cristianoag/MSXUSB/hardware/discontinued/kicad-discrete/MSX USB Drive.png

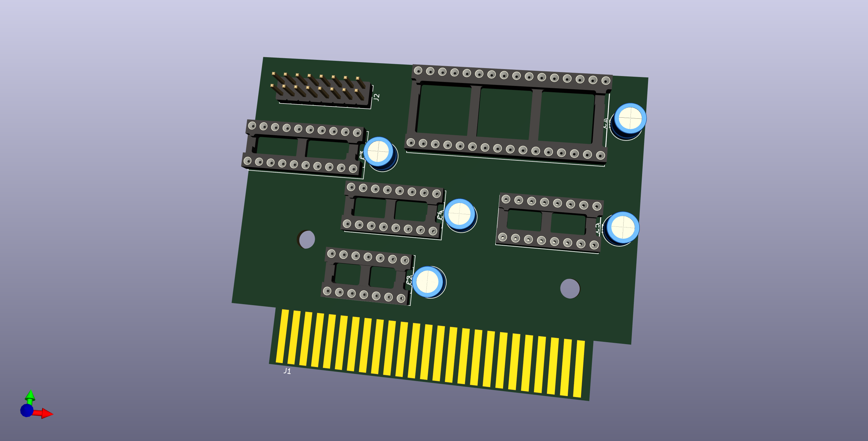
hardware/discontinued/kicad-discrete/MSX USB Drive.png
