cristianoag/MSXUSB/images/2024-11-18_18-22.png

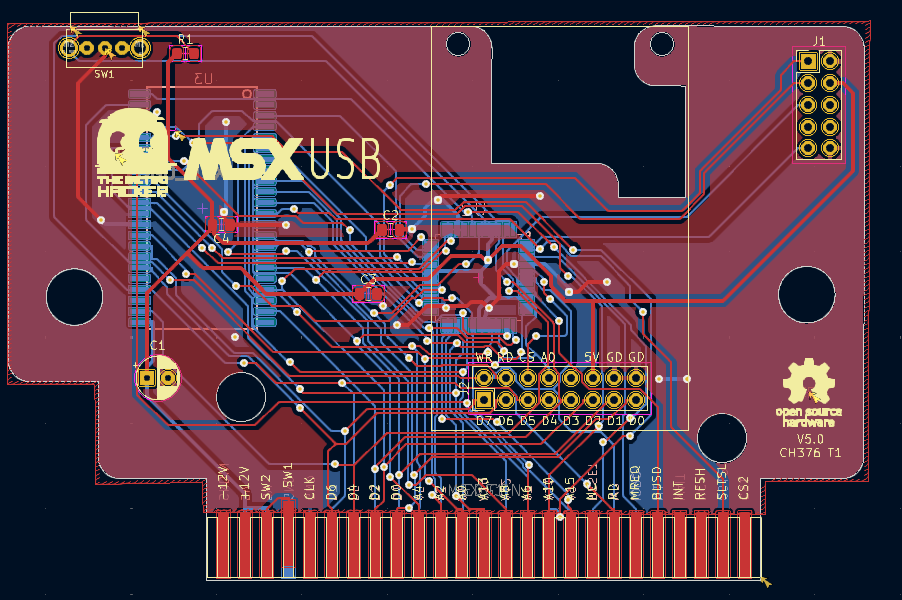
images/2024-11-18_18-22.png
