cristianoag/MSXUSB/(list of files, cad)

Other CAD files:
hardware/v3/quartus/simulation/modelsim/rtl_work/ch376/verilog.psm
hardware/v3/quartus/simulation/modelsim/rtl_work/msxusb/verilog.psm
hardware/v3/quartus/simulation/modelsim/rtl_work/scc_rom_mapper/verilog.psm
hardware/v3/quartus/simulation/modelsim/rtl_work/t_ch376/verilog.psm
hardware/v3/quartus/simulation/modelsim/rtl_work/t_scc_rom_mapper/verilog.psm
hardware/v4/quartus-rev4/simulation/modelsim/rtl_work/ch376/verilog.psm
hardware/v4/quartus-rev4/simulation/modelsim/rtl_work/msxusb/verilog.psm
hardware/v4/quartus-rev4/simulation/modelsim/rtl_work/scc_rom_mapper/verilog.psm
hardware/v4/quartus-rev4/simulation/modelsim/rtl_work/t_ch376/verilog.psm
hardware/v4/quartus-rev4/simulation/modelsim/rtl_work/t_scc_rom_mapper/verilog.psm
hardware/v5/cpld/7064STC44/simulation/modelsim/rtl_work/ch376/verilog.psm
hardware/v5/cpld/7064STC44/simulation/modelsim/rtl_work/msxusb/verilog.psm
hardware/v5/cpld/7064STC44/simulation/modelsim/rtl_work/scc_rom_mapper/verilog.psm
hardware/v5/cpld/7064STC44/simulation/modelsim/rtl_work/t_ch376/verilog.psm
hardware/v5/cpld/7064STC44/simulation/modelsim/rtl_work/t_scc_rom_mapper/verilog.psm
