cristianoag/MSXUSB/hardware/v5/kicad/CH276S-Type1/MSX USB Drive.kicad_pcb

## KiCad design hardware/v5/kicad/CH276S-Type1/MSX USB Drive.kicad_pcb (2025-03-21)

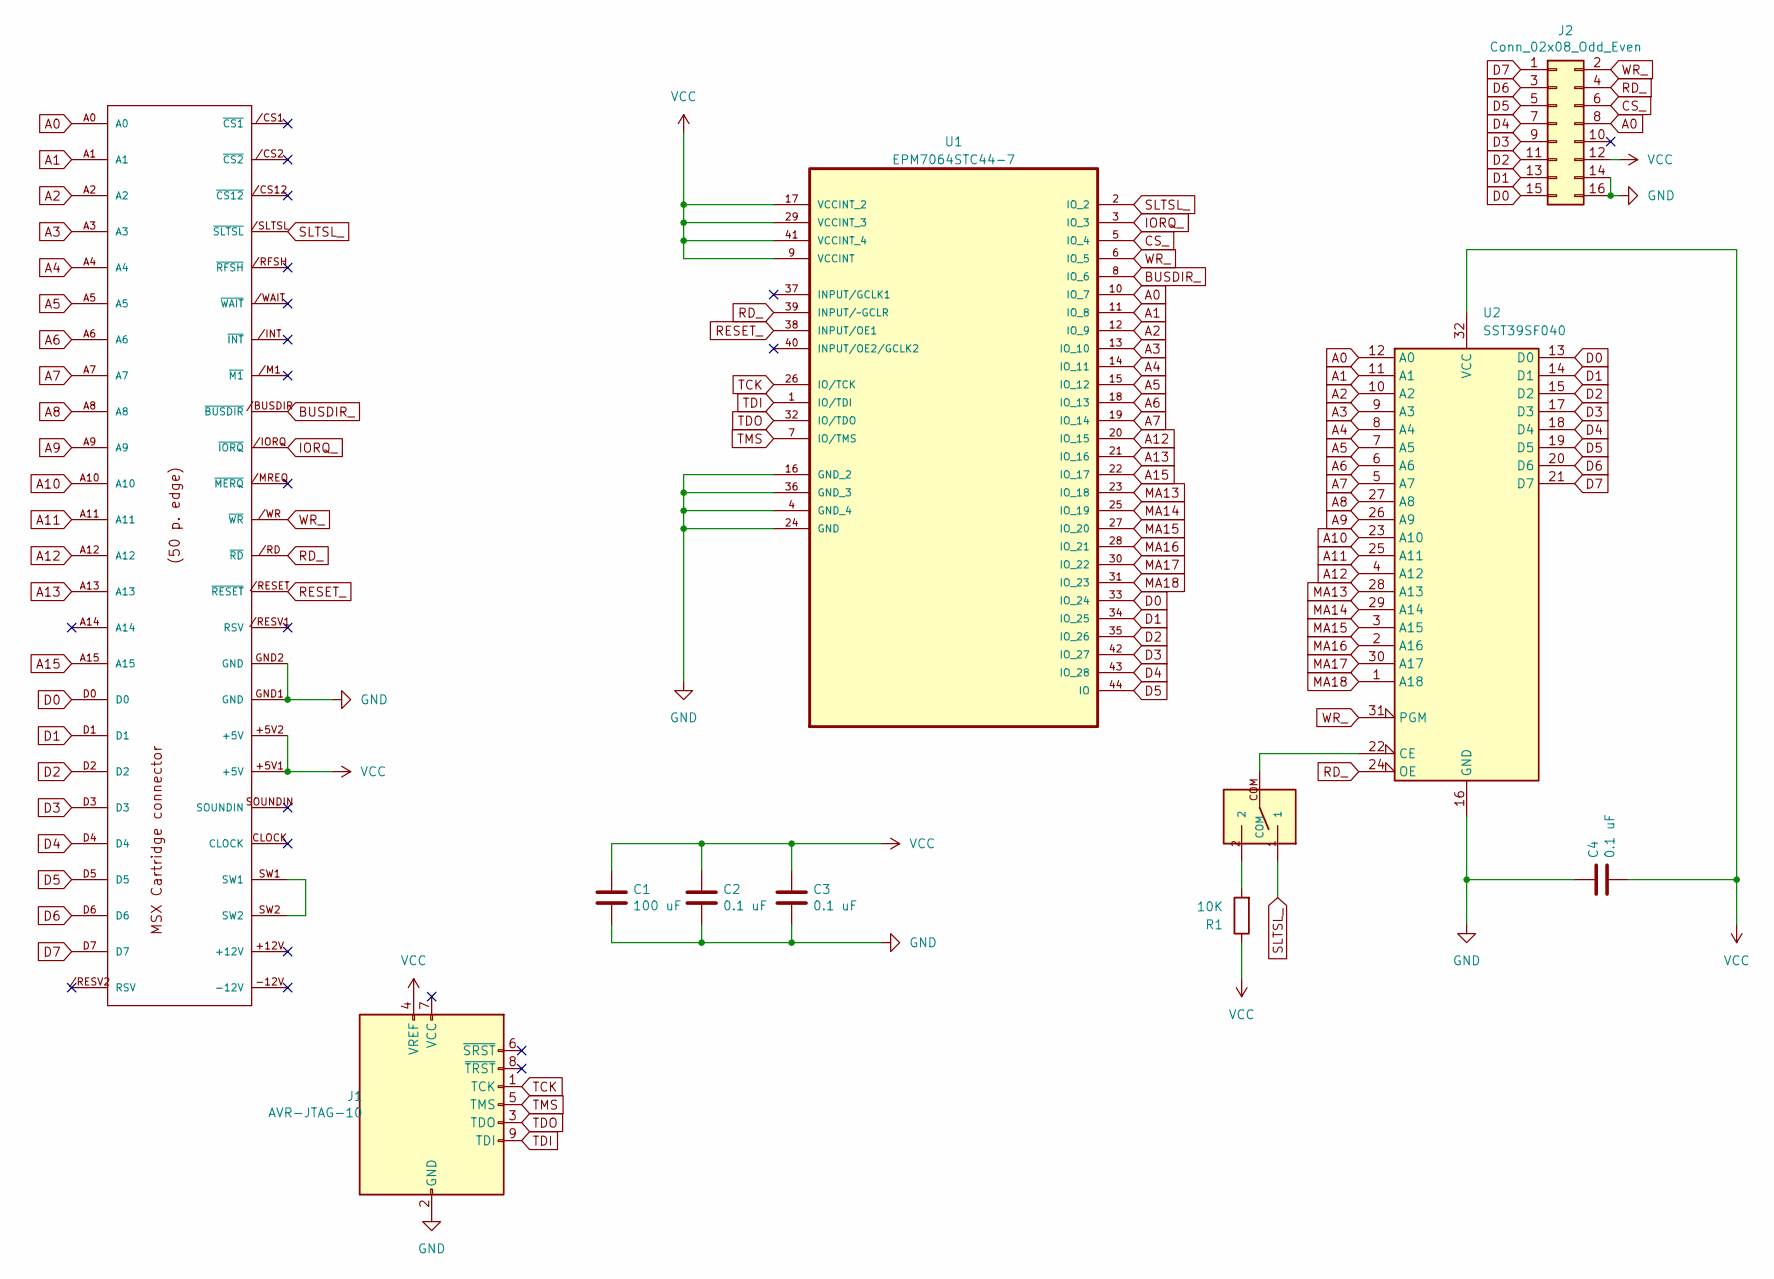
[picture p5: schematic MSX USB Drive.kicad_sch, MSX-USB]

Parts:
C1: 100 uF; CP_Radial_D5.0mm_P2.50mm
C2, C3, C4: 0.1 uF; C_0805_2012Metric_Pad1.18x1.45mm_HandSolder
EDG1: MSX_CON; msx-con-MSXCART
J1: AVR-JTAG-10; PinHeader_2x05_P2.54mm_Vertical
J2: Conn_02x08_Odd_Even; PinHeader_2x08_P2.54mm_Vertical
R1: 10K; R_0805_2012Metric_Pad1.20x1.40mm_HandSolder
SW1: SK12D07VG4
U1: EPM7064STC44-7; QFP80P1200X1200X120-44N; MPN EPM7064STC44-7
U2: SST39SF040; PLCC-32_THT-Socket

Connections:
+12V: EDG1.+12V
-12V: EDG1.-12V
A0: EDG1.A0, J2.8, U1.10 (IO_7), U2.12 (A0)
A1: EDG1.A1, U1.11 (IO_8), U2.11 (A1)
A2: EDG1.A2, U1.12 (IO_9), U2.10 (A2)
A3: EDG1.A3, U1.13 (IO_10), U2.9 (A3)
A4: EDG1.A4, U1.14 (IO_11), U2.8 (A4)
A5: EDG1.A5, U1.15 (IO_12), U2.7 (A5)
A6: EDG1.A6, U1.18 (IO_13), U2.6 (A6)
A7: EDG1.A7, U1.19 (IO_14), U2.5 (A7)
A8: EDG1.A8, U2.27 (A8)
A9: EDG1.A9, U2.26 (A9)
A10: EDG1.A10, U2.23 (A10)
A11: EDG1.A11, U2.25 (A11)
A12: EDG1.A12, U1.20 (IO_15), U2.4 (A12)
A13: EDG1.A13, U1.21 (IO_16)
A14: EDG1.A14
A15: EDG1.A15, U1.22 (IO_17)
BUSDIR_: EDG1./BUSDIR (~BUSDIR), U1.8 (IO_6)
CLOCK: EDG1.CLOCK
CS1: EDG1./CS1 (~CS1)
CS2: EDG1./CS2 (~CS2)
CS12: EDG1./CS12 (~CS12)
CS_: J2.6, U1.5 (IO_4)
D0: EDG1.D0, J2.15, U1.33 (IO_24), U2.13 (D0)
D1: EDG1.D1, J2.13, U1.34 (IO_25), U2.14 (D1)
D2: EDG1.D2, J2.11, U1.35 (IO_26), U2.15 (D2)
D3: EDG1.D3, J2.9, U1.42 (IO_27), U2.17 (D3)
D4: EDG1.D4, J2.7, U1.43 (IO_28), U2.18 (D4)
D5: EDG1.D5, J2.5, U1.44 (IO), U2.19 (D5)
D6: EDG1.D6, J2.3, U2.20 (D6)
D7: EDG1.D7, J2.1, U2.21 (D7)
GND: C1.2, C2.2, C3.2, C4.1, EDG1.GND1 (GND), EDG1.GND2 (GND), J1.2 (GND), J1.10 (GND), J2.14, J2.16, U1.4 (GND_4), U1.16 (GND_2), U1.24 (GND), U1.36 (GND_3), U2.16 (GND)
INT: EDG1./INT (~INT)
IORQ_: EDG1./IORQ (~IORQ), U1.3 (IO_3)
M1: EDG1./M1 (~M1)
MA13: U1.23 (IO_18), U2.28 (A13)
MA14: U1.25 (IO_19), U2.29 (A14)
MA15: U1.27 (IO_20), U2.3 (A15)
MA16: U1.28 (IO_21), U2.2 (A16)
MA17: U1.30 (IO_22), U2.30 (A17)
MA18: U1.31 (IO_23), U2.1 (A18)
MREQ: EDG1./MREQ (~MERQ)
unnamed: EDG1.SW1, EDG1.SW2
unnamed: R1.2, SW1.2
unnamed: SW1.COM, U2.22 (CE)
RD_: EDG1./RD (~RD), J2.4, U1.39 (INPUT/~GCLR), U2.24 (OE)
RESET_: EDG1./RESET (~RESET), U1.38 (INPUT/OE1)
RFSH: EDG1./RFSH (~RFSH)
SLTSL_: EDG1./SLTSL (~SLTSL), SW1.1, U1.2 (IO_2)
SOUNDIN: EDG1.SOUNDIN
TCK: J1.1 (TCK), U1.26 (IO/TCK)
TDI: J1.9 (TDI), U1.1 (IO/TDI)
TDO: J1.3 (TDO), U1.32 (IO/TDO)
TMS: J1.5 (TMS), U1.7 (IO/TMS)
VCC: C1.1, C2.1, C3.1, C4.2, EDG1.+5V1 (+5V), EDG1.+5V2 (+5V), J1.4 (VREF), J2.12, R1.1, U1.9 (VCCINT), U1.17 (VCCINT_2), U1.29 (VCCINT_3), U1.41 (VCCINT_4), U2.32 (VCC)
WAIT: EDG1./WAIT (~WAIT)
WR_: EDG1./WR (~WR), J2.2, U1.6 (IO_5), U2.31 (PGM)

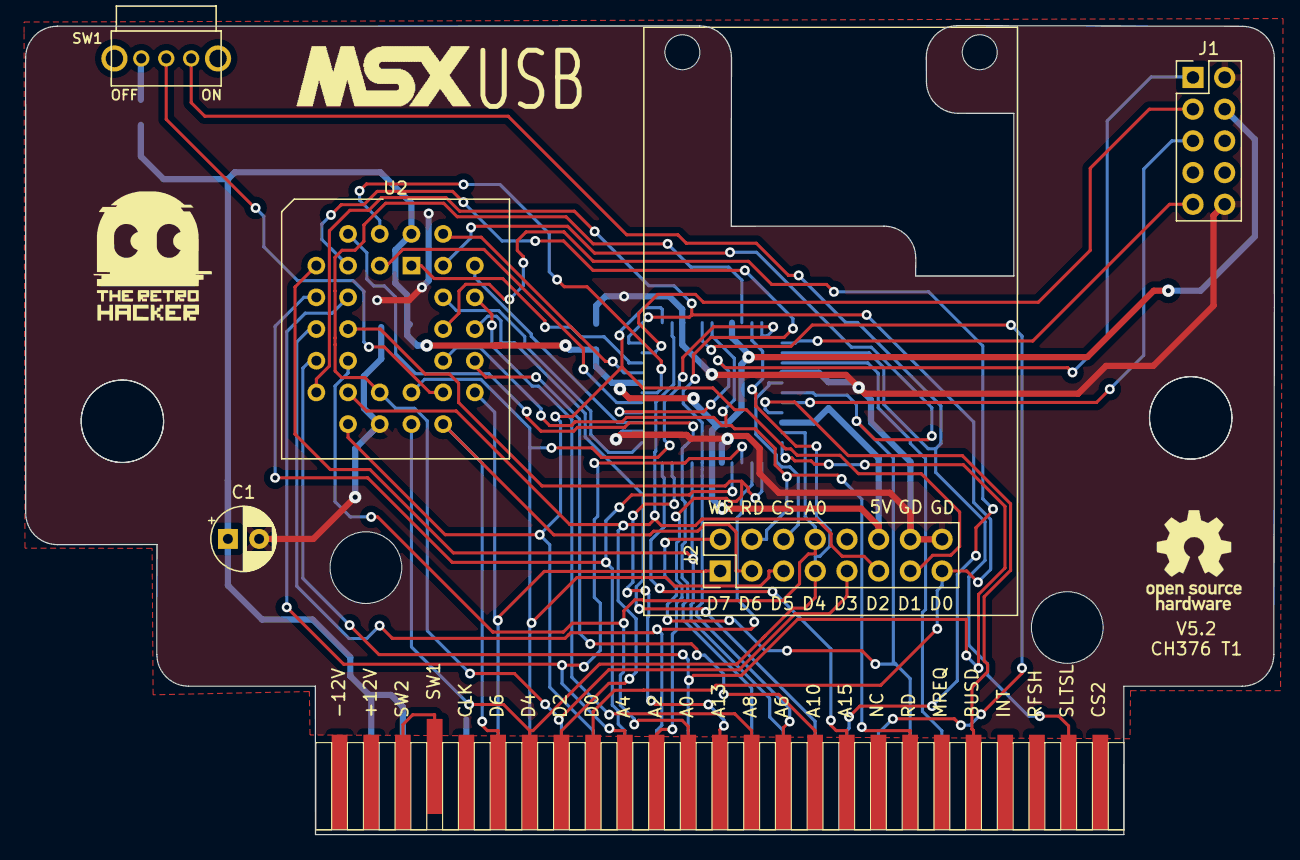
[picture p6: board hardware/v5/kicad/CH276S-Type1/MSX USB Drive.kicad_pcb from above]

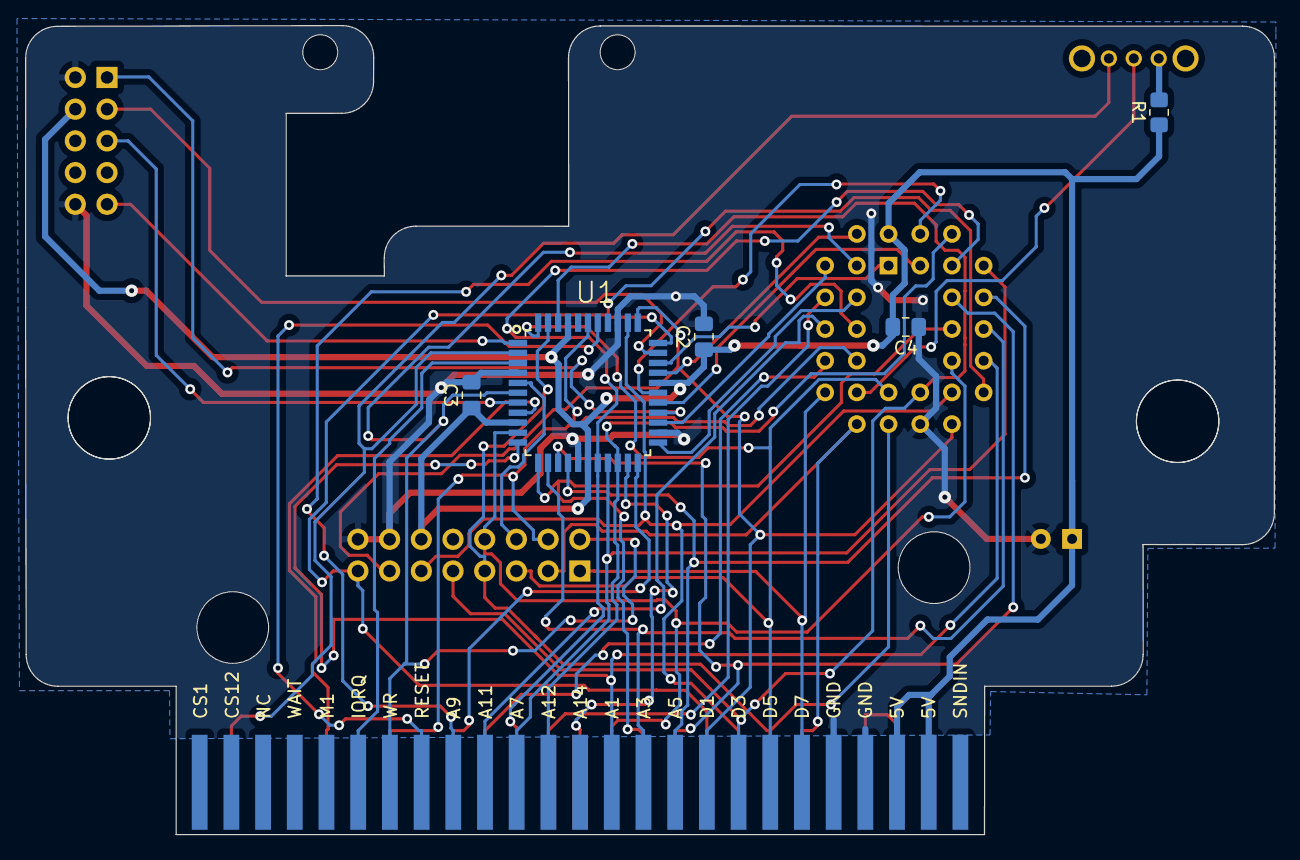
[picture p7: board hardware/v5/kicad/CH276S-Type1/MSX USB Drive.kicad_pcb from below]

Board: 2 copper layers, 100.1 x 64.8 mm, 12 parts (5 on the bottom side), 45 nets.

Other parts of the board:
LOGO_MSX: LOGO_MSX
