cristianoag/MSXUSB/hardware/v4/kicad-cpld-rev4/MSX USB Drive.kicad_pcb

## KiCad design hardware/v4/kicad-cpld-rev4/MSX USB Drive.kicad_pcb (2025-03-21, an earlier design)

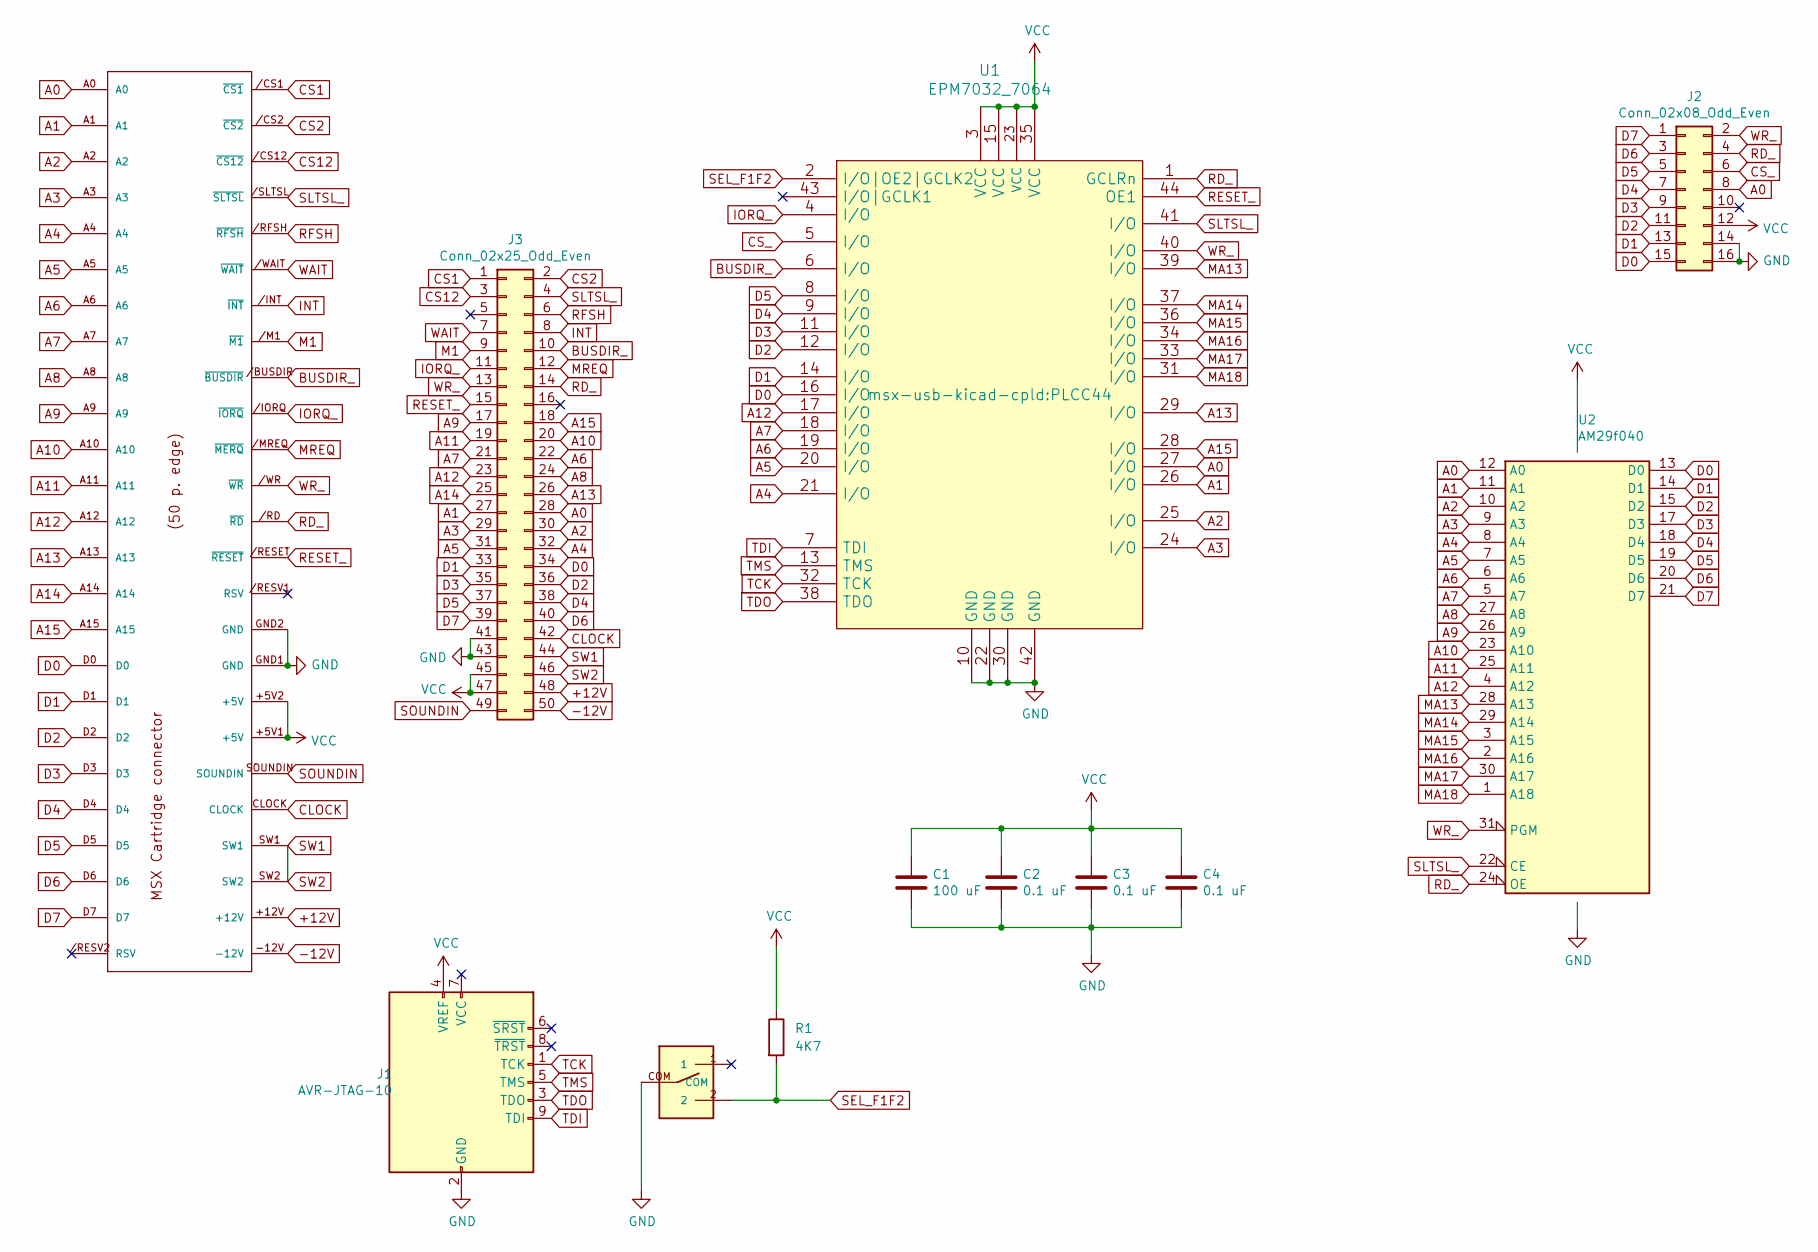
[picture p8: schematic MSX USB Drive.kicad_sch]

Parts:
C1: 100 uF; CP_Radial_D5.0mm_P2.50mm
C2, C3, C4: 0.1 uF; C_0805_2012Metric_Pad1.18x1.45mm_HandSolder
EDG1: MSX_CON; msx-con-MSXCART
J1: AVR-JTAG-10; PinHeader_2x05_P2.54mm_Vertical
J2: Conn_02x08_Odd_Even; PinHeader_2x08_P2.54mm_Vertical
J3: Conn_02x25_Odd_Even; PinHeader_2x25_P2.54mm_Vertical
R1: 4K7; R_0805_2012Metric_Pad1.20x1.40mm_HandSolder
SW1: SK12D07VG4
U1: EPM7032_7064; PLCC44
U2: AM29f040; PLCC-32_THT-Socket

Connections:
+12V: EDG1.+12V, J3.48
-12V: EDG1.-12V, J3.50
A0: EDG1.A0, J2.8, J3.28, U1.27 (I/O), U2.12 (A0)
A1: EDG1.A1, J3.27, U1.26 (I/O), U2.11 (A1)
A2: EDG1.A2, J3.30, U1.25 (I/O), U2.10 (A2)
A3: EDG1.A3, J3.29, U1.24 (I/O), U2.9 (A3)
A4: EDG1.A4, J3.32, U1.21 (I/O), U2.8 (A4)
A5: EDG1.A5, J3.31, U1.20 (I/O), U2.7 (A5)
A6: EDG1.A6, J3.22, U1.19 (I/O), U2.6 (A6)
A7: EDG1.A7, J3.21, U1.18 (I/O), U2.5 (A7)
A8: EDG1.A8, J3.24, U2.27 (A8)
A9: EDG1.A9, J3.17, U2.26 (A9)
A10: EDG1.A10, J3.20, U2.23 (A10)
A11: EDG1.A11, J3.19, U2.25 (A11)
A12: EDG1.A12, J3.23, U1.17 (I/O), U2.4 (A12)
A13: EDG1.A13, J3.26, U1.29 (I/O)
A14: EDG1.A14, J3.25
A15: EDG1.A15, J3.18, U1.28 (I/O)
BUSDIR_: EDG1./BUSDIR (~BUSDIR), J3.10, U1.6 (I/O)
CLOCK: EDG1.CLOCK, J3.42
CS1: EDG1./CS1 (~CS1), J3.1
CS2: EDG1./CS2 (~CS2), J3.2
CS12: EDG1./CS12 (~CS12), J3.3
CS_: J2.6, U1.5 (I/O)
D0: EDG1.D0, J2.15, J3.34, U1.16 (I/O), U2.13 (D0)
D1: EDG1.D1, J2.13, J3.33, U1.14 (I/O), U2.14 (D1)
D2: EDG1.D2, J2.11, J3.36, U1.12 (I/O), U2.15 (D2)
D3: EDG1.D3, J2.9, J3.35, U1.11 (I/O), U2.17 (D3)
D4: EDG1.D4, J2.7, J3.38, U1.9 (I/O), U2.18 (D4)
D5: EDG1.D5, J2.5, J3.37, U1.8 (I/O), U2.19 (D5)
D6: EDG1.D6, J2.3, J3.40, U2.20 (D6)
D7: EDG1.D7, J2.1, J3.39, U2.21 (D7)
GND: C1.2, C2.2, C3.2, C4.2, EDG1.GND1 (GND), EDG1.GND2 (GND), J1.2 (GND), J1.10 (GND), J2.14, J2.16, J3.41, J3.43, SW1.COM, U1.10 (GND), U1.22 (GND), U1.30 (GND), U1.42 (GND), U2.16 (GND)
INT: EDG1./INT (~INT), J3.8
IORQ_: EDG1./IORQ (~IORQ), J3.11, U1.4 (I/O)
M1: EDG1./M1 (~M1), J3.9
MA13: U1.39 (I/O), U2.28 (A13)
MA14: U1.37 (I/O), U2.29 (A14)
MA15: U1.36 (I/O), U2.3 (A15)
MA16: U1.34 (I/O), U2.2 (A16)
MA17: U1.33 (I/O), U2.30 (A17)
MA18: U1.31 (I/O), U2.1 (A18)
MREQ: EDG1./MREQ (~MERQ), J3.12
RD_: EDG1./RD (~RD), J2.4, J3.14, U1.1 (GCLRn), U2.24 (OE)
RESET_: EDG1./RESET (~RESET), J3.15, U1.44 (OE1)
RFSH: EDG1./RFSH (~RFSH), J3.6
SEL_F1F2: R1.2, SW1.2, U1.2 (I/O|OE2|GCLK2)
SLTSL_: EDG1./SLTSL (~SLTSL), J3.4, U1.41 (I/O), U2.22 (CE)
SOUNDIN: EDG1.SOUNDIN, J3.49
SW1: EDG1.SW1, EDG1.SW2, J3.44, J3.46
TCK: J1.1 (TCK), U1.32 (TCK)
TDI: J1.9 (TDI), U1.7 (TDI)
TDO: J1.3 (TDO), U1.38 (TDO)
TMS: J1.5 (TMS), U1.13 (TMS)
VCC: C1.1, C2.1, C3.1, C4.1, EDG1.+5V1 (+5V), EDG1.+5V2 (+5V), J1.4 (VREF), J2.12, J3.45, J3.47, R1.1, U1.3 (VCC), U1.15 (VCC), U1.23 (VCC), U1.35 (VCC), U2.32 (VCC)
WAIT: EDG1./WAIT (~WAIT), J3.7
WR_: EDG1./WR (~WR), J2.2, J3.13, U1.40 (I/O), U2.31 (PGM)

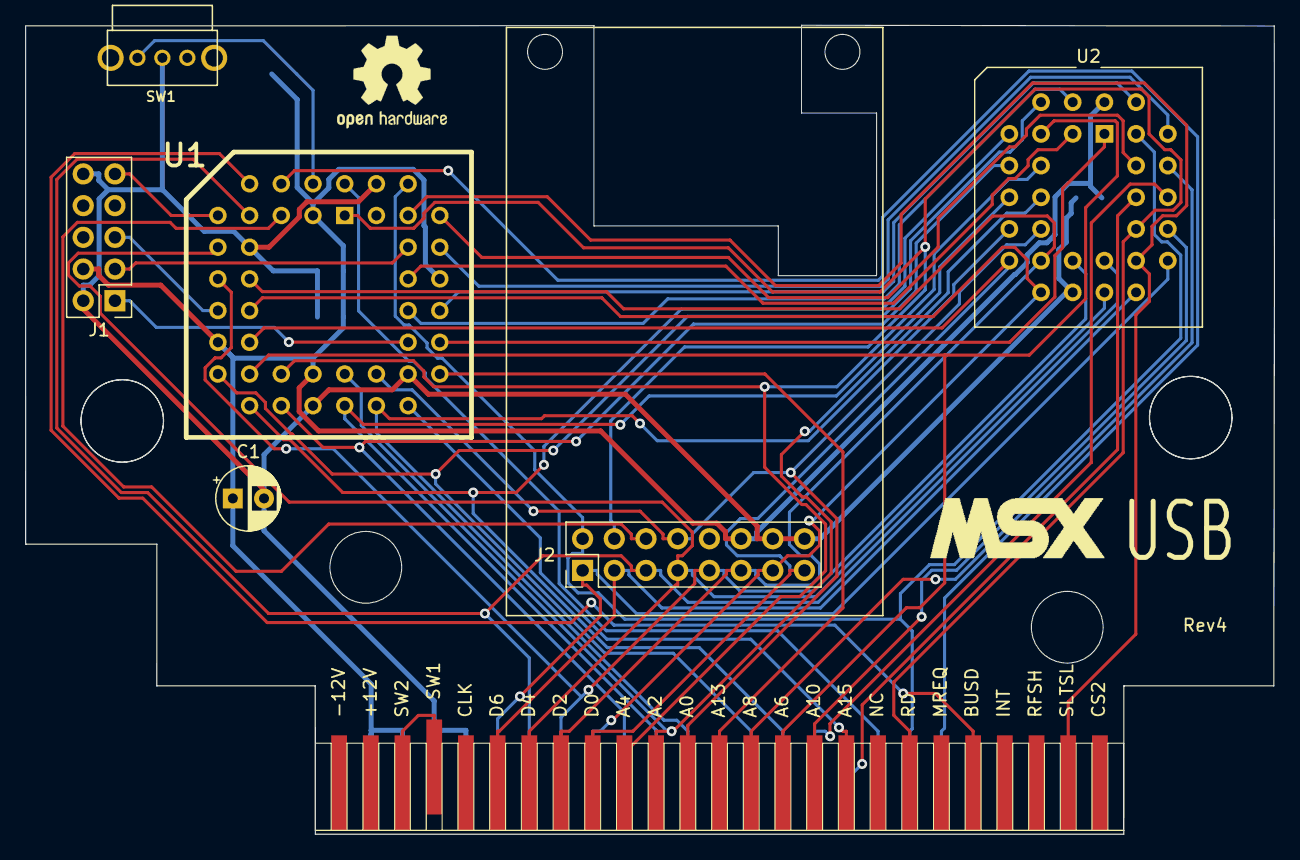
[picture p9: board hardware/v4/kicad-cpld-rev4/MSX USB Drive.kicad_pcb from above]

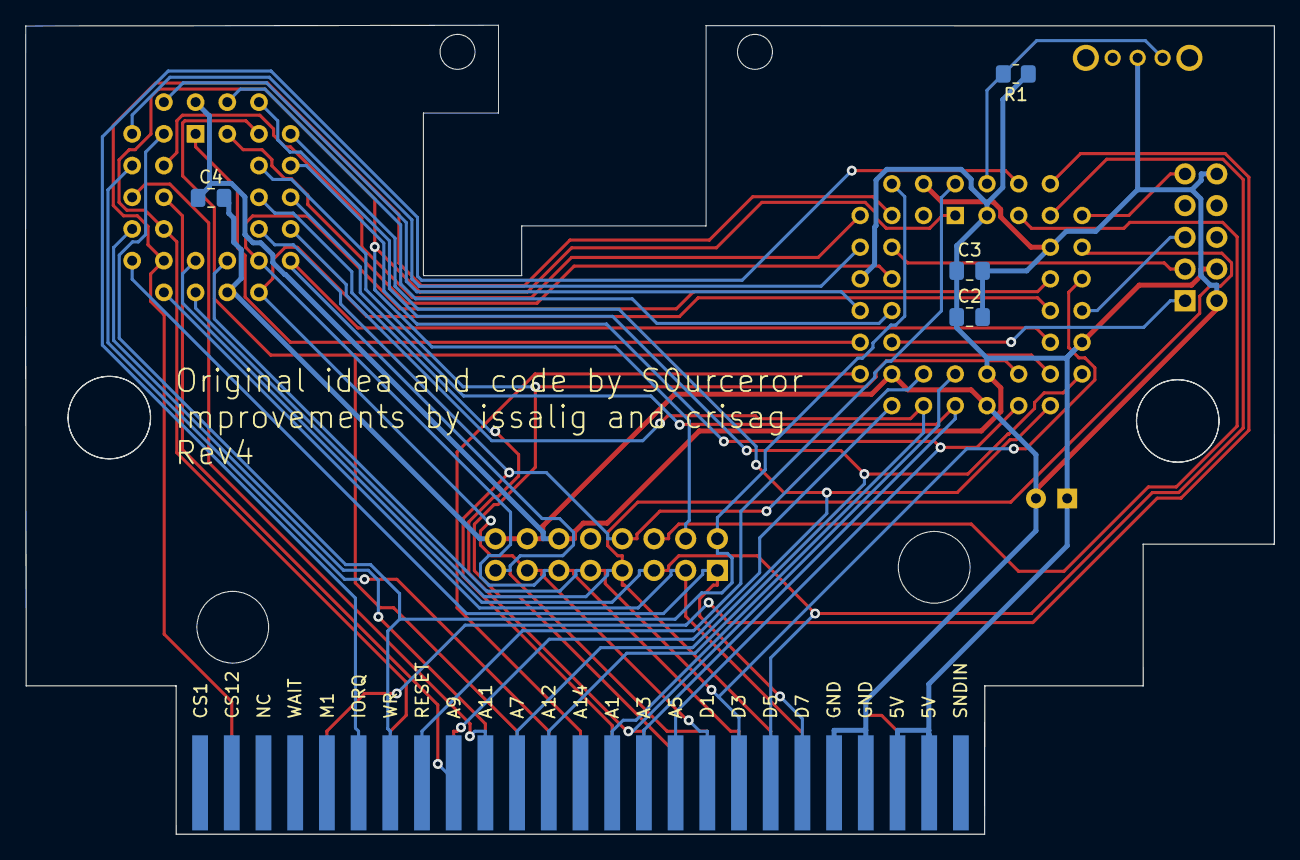
[picture p10: board hardware/v4/kicad-cpld-rev4/MSX USB Drive.kicad_pcb from below]

Board: 2 copper layers, 100.1 x 64.8 mm, 12 parts (4 on the bottom side), 44 nets.

Other parts of the board:
LOGO_MSX: LOGO_MSX
