cristianoag/MSXUSB/hardware/v3/kicad-cpld/MSX USB Drive.kicad_pcb

## KiCad design hardware/v3/kicad-cpld/MSX USB Drive.kicad_pcb (2025-03-21, an earlier design)

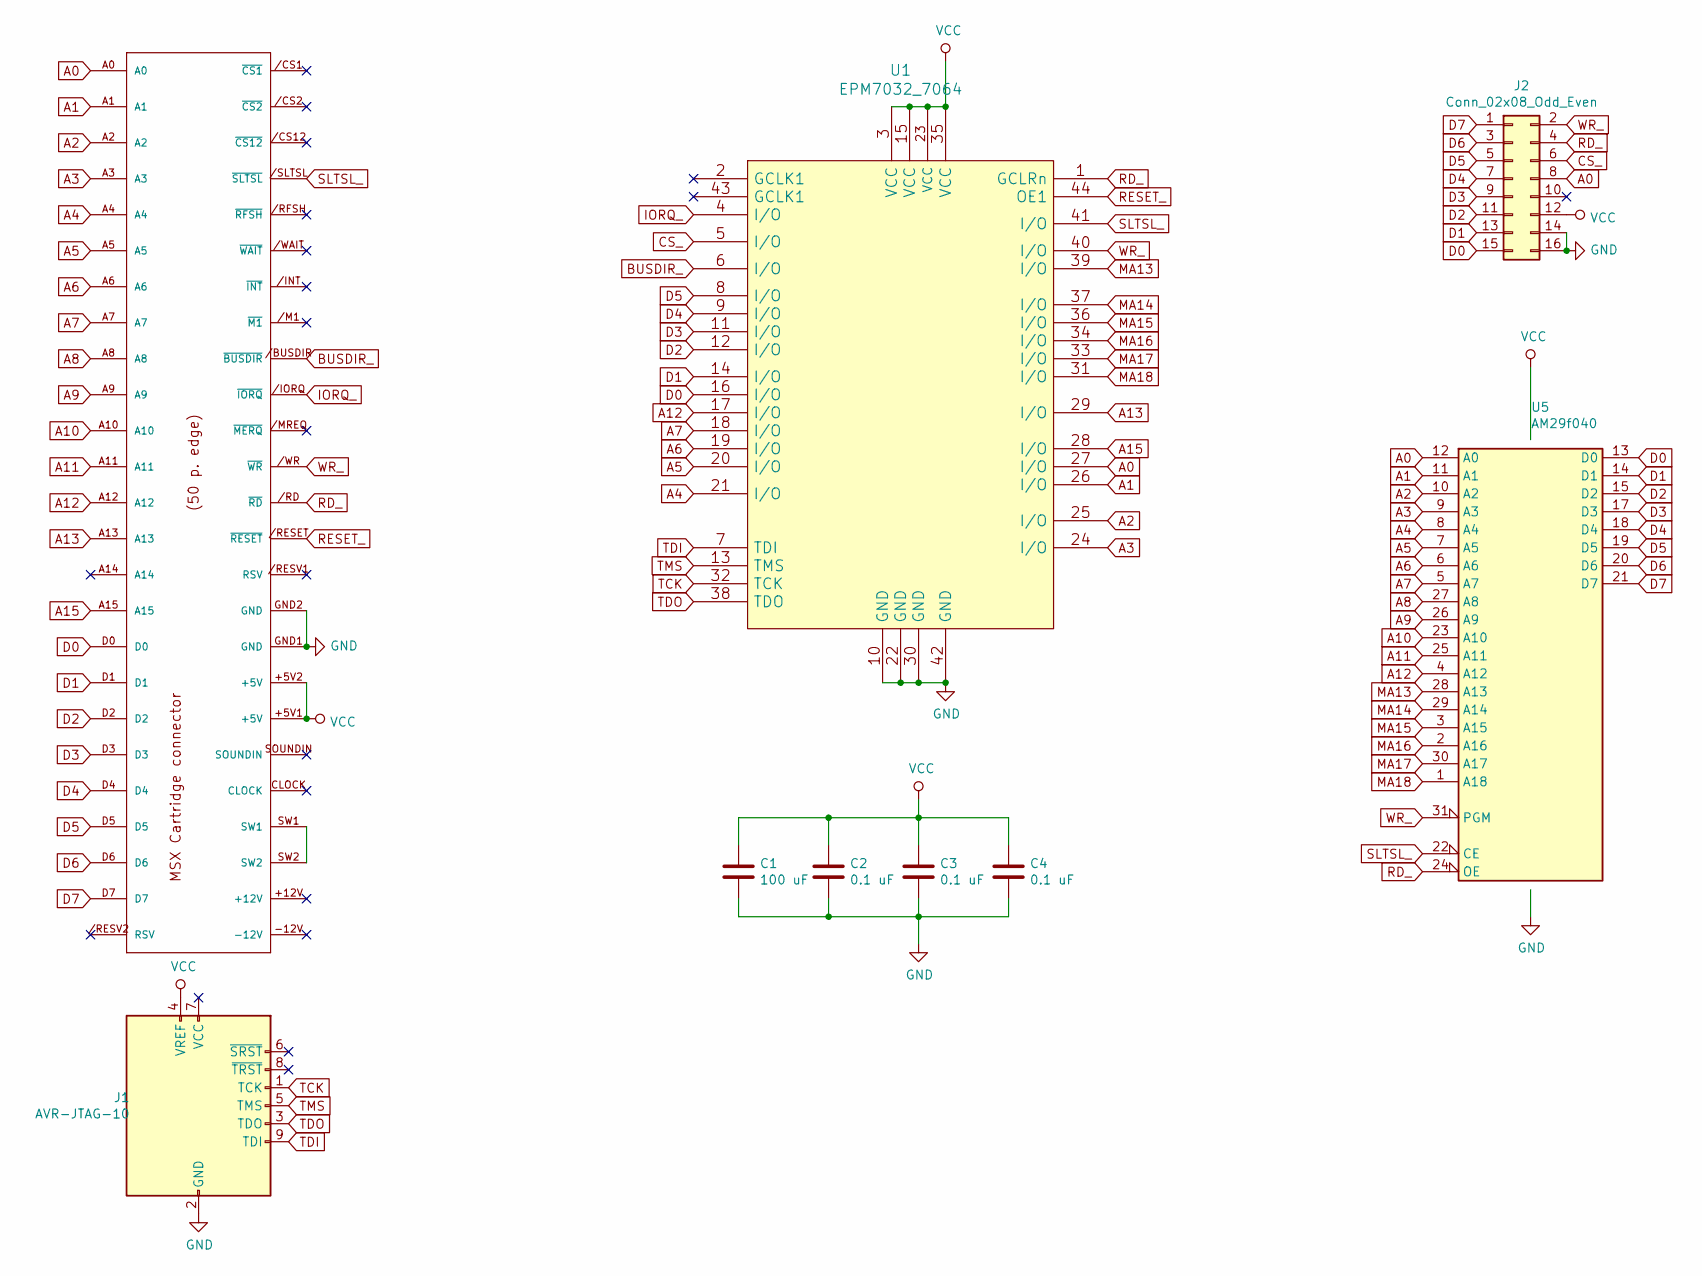
[picture p11: schematic MSX USB Drive.sch]

Parts:
C1: 100 uF; CP_Elec_6.3x5.4
C2, C3, C4: 0.1 uF; C_0805_2012Metric_Pad1.15x1.40mm_HandSolder
EDG1: MSX_CON; msx-con-MSXCART
J1: AVR-JTAG-10; PinHeader_2x05_P2.54mm_Vertical
J2: Conn_02x08_Odd_Even; PinHeader_2x08_P2.54mm_Vertical
U1: EPM7032_7064; PLCC44
U5: AM29f040; DIP-32_W15.24mm_Socket

Connections:
A0: EDG1.A0, J2.8, U1.27 (I/O), U5.12 (A0)
A1: EDG1.A1, U1.26 (I/O), U5.11 (A1)
A2: EDG1.A2, U1.25 (I/O), U5.10 (A2)
A3: EDG1.A3, U1.24 (I/O), U5.9 (A3)
A4: EDG1.A4, U1.21 (I/O), U5.8 (A4)
A5: EDG1.A5, U1.20 (I/O), U5.7 (A5)
A6: EDG1.A6, U1.19 (I/O), U5.6 (A6)
A7: EDG1.A7, U1.18 (I/O), U5.5 (A7)
A8: EDG1.A8, U5.27 (A8)
A9: EDG1.A9, U5.26 (A9)
A10: EDG1.A10, U5.23 (A10)
A11: EDG1.A11, U5.25 (A11)
A12: EDG1.A12, U1.17 (I/O), U5.4 (A12)
A13: EDG1.A13, U1.29 (I/O)
A15: EDG1.A15, U1.28 (I/O)
BUSDIR_: EDG1./BUSDIR (~BUSDIR), U1.6 (I/O)
CS_: J2.6, U1.5 (I/O)
D0: EDG1.D0, J2.15, U1.16 (I/O), U5.13 (D0)
D1: EDG1.D1, J2.13, U1.14 (I/O), U5.14 (D1)
D2: EDG1.D2, J2.11, U1.12 (I/O), U5.15 (D2)
D3: EDG1.D3, J2.9, U1.11 (I/O), U5.17 (D3)
D4: EDG1.D4, J2.7, U1.9 (I/O), U5.18 (D4)
D5: EDG1.D5, J2.5, U1.8 (I/O), U5.19 (D5)
D6: EDG1.D6, J2.3, U5.20 (D6)
D7: EDG1.D7, J2.1, U5.21 (D7)
GND: C1.2, C2.2, C3.2, C4.2, EDG1.GND1 (GND), EDG1.GND2 (GND), J1.2 (GND), J1.10 (GND), J2.14, J2.16, U1.10 (GND), U1.22 (GND), U1.30 (GND), U1.42 (GND), U5.16 (GND)
IORQ_: EDG1./IORQ (~IORQ), U1.4 (I/O)
MA13: U1.39 (I/O), U5.28 (A13)
MA14: U1.37 (I/O), U5.29 (A14)
MA15: U1.36 (I/O), U5.3 (A15)
MA16: U1.34 (I/O), U5.2 (A16)
MA17: U1.33 (I/O), U5.30 (A17)
MA18: U1.31 (I/O), U5.1 (A18)
unnamed: EDG1.SW1, EDG1.SW2
RD_: EDG1./RD (~RD), J2.4, U1.1 (GCLRn), U5.24 (OE)
RESET_: EDG1./RESET (~RESET), U1.44 (OE1)
SLTSL_: EDG1./SLTSL (~SLTSL), U1.41 (I/O), U5.22 (CE)
TCK: J1.1 (TCK), U1.32 (TCK)
TDI: J1.9 (TDI), U1.7 (TDI)
TDO: J1.3 (TDO), U1.38 (TDO)
TMS: J1.5 (TMS), U1.13 (TMS)
VCC: C1.1, C2.1, C3.1, C4.1, EDG1.+5V1 (+5V), EDG1.+5V2 (+5V), J1.4 (VREF), J2.12, U1.3 (VCC), U1.15 (VCC), U1.23 (VCC), U1.35 (VCC), U5.32 (VCC)
WR_: EDG1./WR (~WR), J2.2, U1.40 (I/O), U5.31 (PGM)

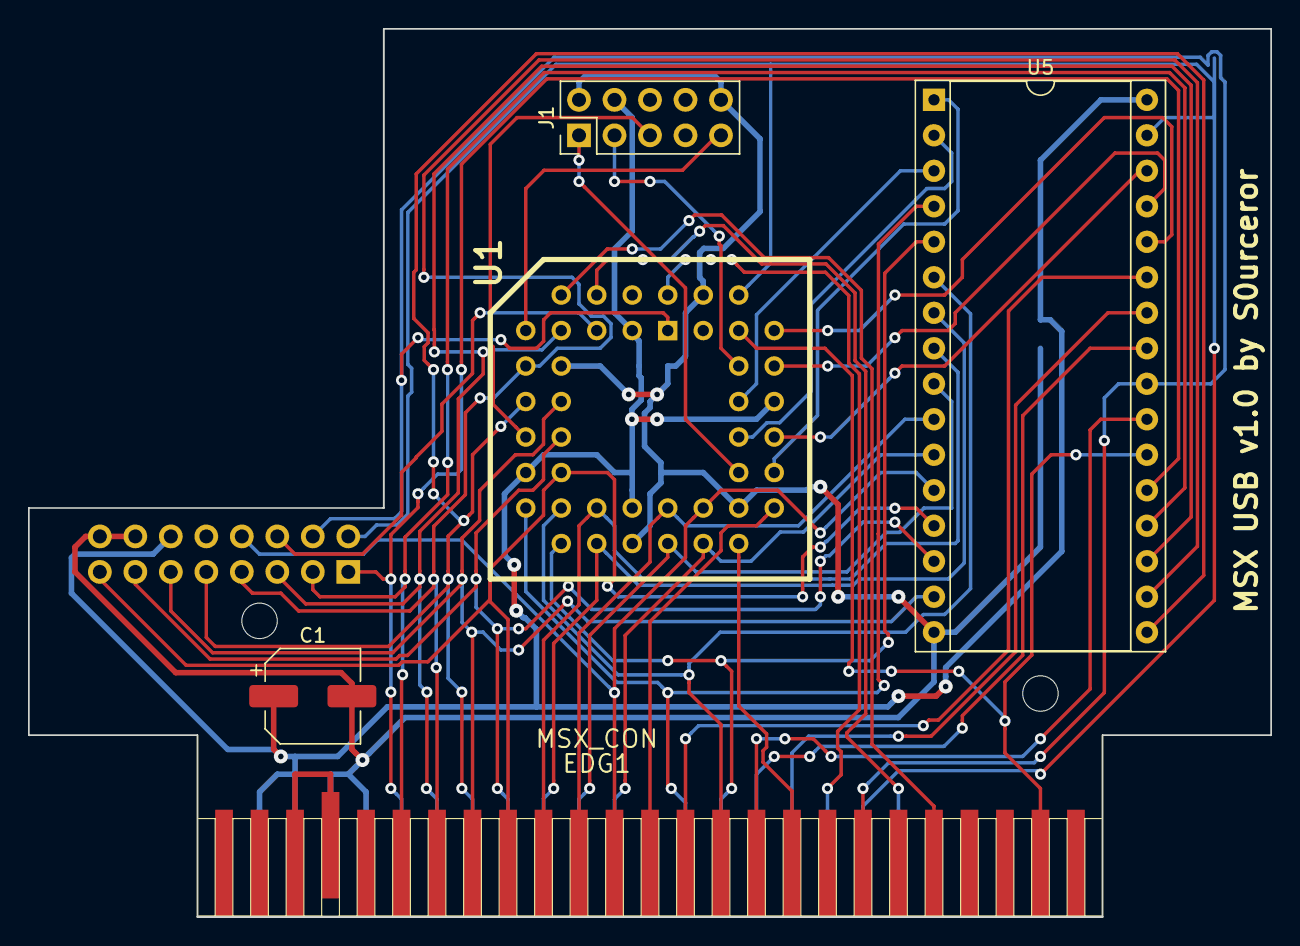
[picture p12: board hardware/v3/kicad-cpld/MSX USB Drive.kicad_pcb from above]

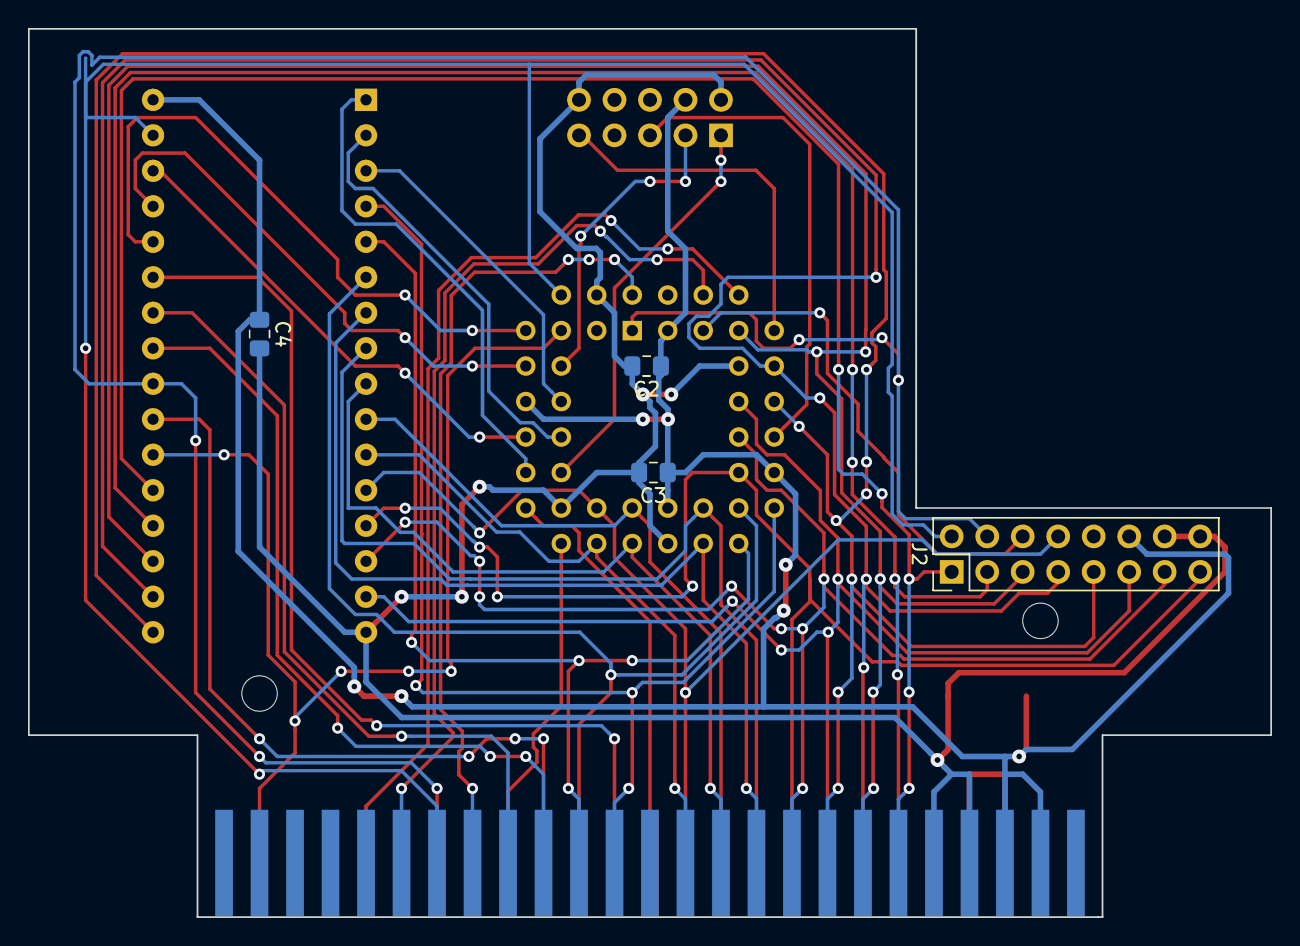
[picture p13: board hardware/v3/kicad-cpld/MSX USB Drive.kicad_pcb from below]

Board: 2 copper layers, 88.9 x 63.6 mm, 9 parts (4 on the bottom side), 43 nets.
