cristianoag/MSXUSB/hardware/discontinued/kicad-discrete/MSX USB Drive.kicad_pcb

## KiCad design hardware/discontinued/kicad-discrete/MSX USB Drive.kicad_pcb (2025-03-21)

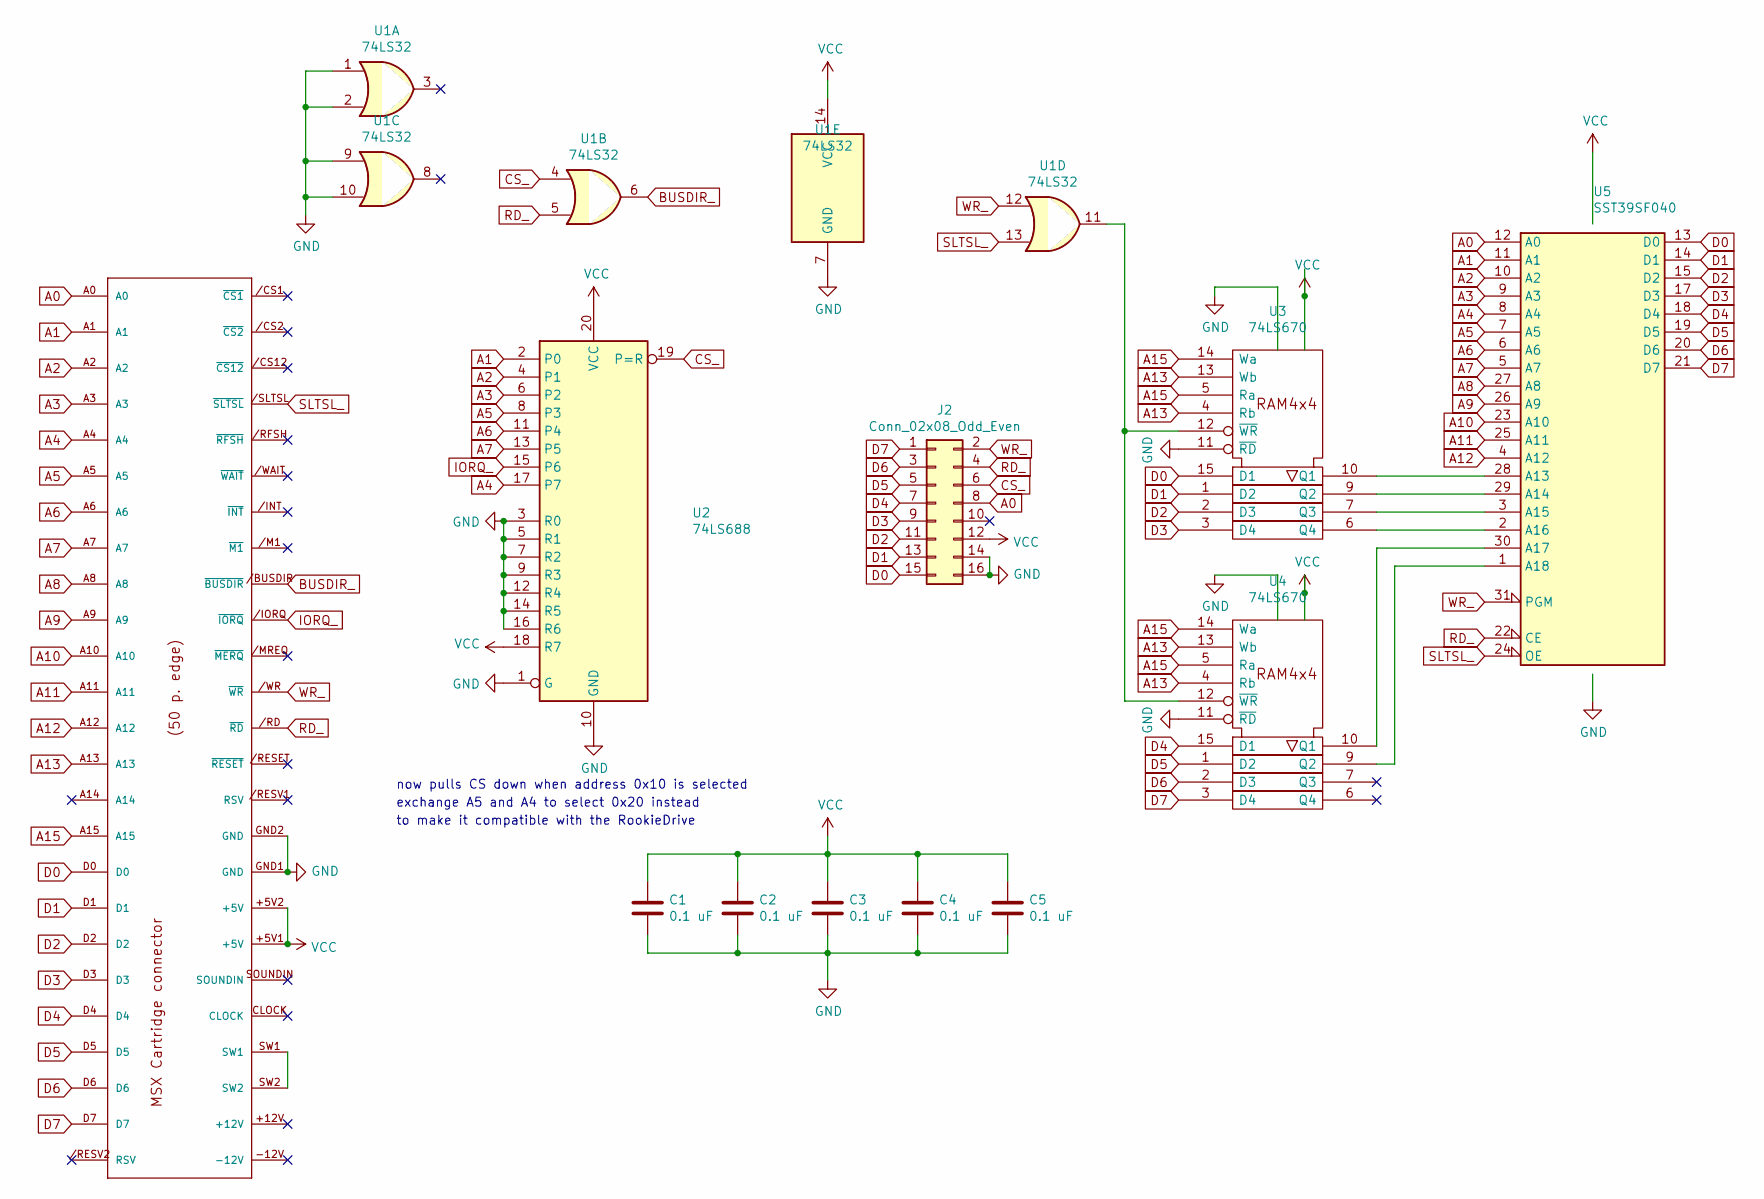
[picture p14: schematic MSX USB Drive.sch]

Parts:
C1, C2, C3, C4, C5: 0.1 uF; C_Radial_D6.3mm_H5.0mm_P2.50mm
EDG1: MSX_CON; msx-con-MSXCART
J2: Conn_02x08_Odd_Even; PinHeader_2x08_P2.54mm_Vertical
U1: 74LS32; DIP-14_W7.62mm_Socket
U2: 74LS688; DIP-20_W7.62mm_Socket
U3, U4: 74LS670; DIP-16_W7.62mm_Socket
U5: SST39SF040; DIP-32_W15.24mm_Socket

Connections:
A0: EDG1.A0, J2.8, U5.12 (A0)
A1: EDG1.A1, U2.2 (P0), U5.11 (A1)
A2: EDG1.A2, U2.4 (P1), U5.10 (A2)
A3: EDG1.A3, U2.6 (P2), U5.9 (A3)
A4: EDG1.A4, U2.17 (P7), U5.8 (A4)
A5: EDG1.A5, U2.8 (P3), U5.7 (A5)
A6: EDG1.A6, U2.11 (P4), U5.6 (A6)
A7: EDG1.A7, U2.13 (P5), U5.5 (A7)
A8: EDG1.A8, U5.27 (A8)
A9: EDG1.A9, U5.26 (A9)
A10: EDG1.A10, U5.23 (A10)
A11: EDG1.A11, U5.25 (A11)
A12: EDG1.A12, U5.4 (A12)
A13: EDG1.A13, U3.4 (Rb), U3.13 (Wb), U4.4 (Rb), U4.13 (Wb)
A15: EDG1.A15, U3.5 (Ra), U3.14 (Wa), U4.5 (Ra), U4.14 (Wa)
BUSDIR_: EDG1./BUSDIR (~BUSDIR), U1.6
CS_: J2.6, U1.4, U2.19 (P=R)
D0: EDG1.D0, J2.15, U3.15 (D1), U5.13 (D0)
D1: EDG1.D1, J2.13, U3.1 (D2), U5.14 (D1)
D2: EDG1.D2, J2.11, U3.2 (D3), U5.15 (D2)
D3: EDG1.D3, J2.9, U3.3 (D4), U5.17 (D3)
D4: EDG1.D4, J2.7, U4.15 (D1), U5.18 (D4)
D5: EDG1.D5, J2.5, U4.1 (D2), U5.19 (D5)
D6: EDG1.D6, J2.3, U4.2 (D3), U5.20 (D6)
D7: EDG1.D7, J2.1, U4.3 (D4), U5.21 (D7)
GND: C1.2, C2.2, C3.2, C4.2, C5.2, EDG1.GND1 (GND), EDG1.GND2 (GND), J2.14, J2.16, U1.1, U1.2, U1.7 (GND), U1.9, U1.10, U2.1 (G), U2.3 (R0), U2.5 (R1), U2.7 (R2), U2.9 (R3), U2.10 (GND), U2.12 (R4), U2.14 (R5), U2.16 (R6), U3.8 (GND), U3.11 (~RD), U4.8 (GND), U4.11 (~RD), U5.16 (GND)
IORQ_: EDG1./IORQ (~IORQ), U2.15 (P6)
unnamed: EDG1.SW1, EDG1.SW2
unnamed: U3.6 (Q4), U5.2 (A16)
unnamed: U3.7 (Q3), U5.3 (A15)
unnamed: U3.9 (Q2), U5.29 (A14)
unnamed: U3.10 (Q1), U5.28 (A13)
unnamed: U4.9 (Q2), U5.1 (A18)
unnamed: U4.10 (Q1), U5.30 (A17)
RD_: EDG1./RD (~RD), J2.4, U1.5, U5.22 (CE)
SLTSL_: EDG1./SLTSL (~SLTSL), U1.13, U5.24 (OE)
VCC: C1.1, C2.1, C3.1, C4.1, C5.1, EDG1.+5V1 (+5V), EDG1.+5V2 (+5V), J2.12, U1.14 (VCC), U2.18 (R7), U2.20 (VCC), U3.16 (VCC), U4.16 (VCC), U5.32 (VCC)
WR_: EDG1./WR (~WR), J2.2, U1.12, U5.31 (PGM)

Notes on the sheet:
now pulls CS down when address 0x10 is selected
exchange A5 and A4 to select 0x20 instead
to make it compatible with the RookieDrive

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
Board: 2 copper layers, 12 parts (0 on the bottom side), 39 nets, no tracks yet.
