cristianoag/MSXUSB/(commit log)

2025-03-21 init on private
    [MSX USB Drive-B_Cu.gbr, MSX USB Drive-B_Mask.gbr, MSX USB Drive-B_Paste.gbr, MSX USB Drive-B_SilkS.gbr, MSX USB Drive-Edge_Cuts.gbr, MSX USB Drive-F_Cu.gbr, MSX USB Drive-F_Mask.gbr, MSX USB Drive-F_Paste.gbr]
2026-09-24 Add endpoint 0 diagnostics for USB device descriptor retrieval
    This commit introduces a new assembly file `diag_ep0.asm` that implements various diagnostic tests for USB endpoint 0. The tests aim to troubleshoot issues with control transfer data stages, particularly for devices with a maximum packet size of 8 bytes. The diagnostics include experiments for retrieving device descriptors, handling built-in CH376 commands, and executing SETUP and CBI commands. Each experiment logs the raw CH376 status and the number of bytes received, aiding in the identification of communication issues with USB devices.
